jellewie/Smart-Stairs/Schematic-PCB/2023-06-21 V1.1 PCB Top.png

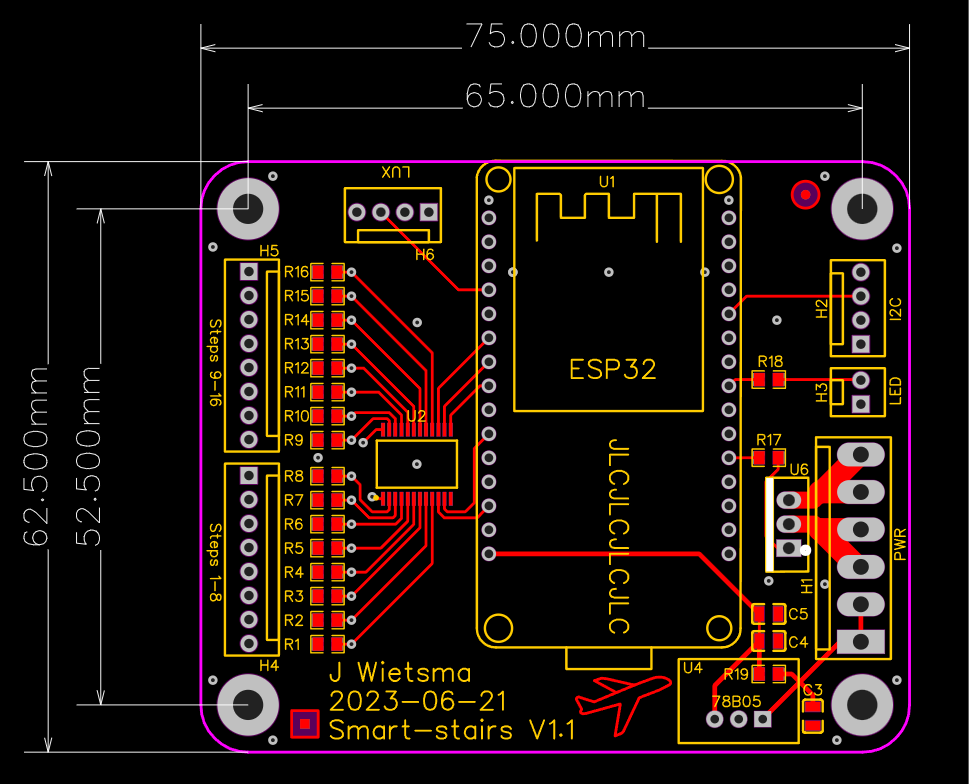
Schematic-PCB/2023-06-21 V1.1 PCB Top.png
