jellewie/Smart-Stairs/(commit log)

2023-09-27 Readme and schematic files
2023-09-27 Update to get it in like with PCB V1.1
2023-11-04 Made the LEDs work
    - Fixed last step size
    - Matched pin strapping to the PCB version
2024-03-23 Added WiFi support + HA MQTT
    The current MQTT integration with Home Assistant is just ENABLE/DISABLE the leds completely
2024-03-24 Updated version number to match PCB
2024-03-28 Added the option for LX sensor on pin 36
2024-04-04 Added power consumtion estimates
2026-01-04 Add HA motion sensor
2026-01-04 Clear leds by a mode change
    clear leds and timers when changing back to stairs mode
2026-01-05 Wrap LED controll in wrapper
    Protection out of array bounds
2026-09-21 Make step 14 work
    We have 13 LEDs on 13 steps+the floor step.
